cottjr/DMS-Laser-Cutter-Usage-Timer/Code and Verification/Verification/Yellow when need to pay.png

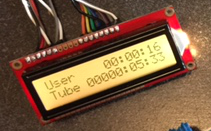
Code and Verification/Verification/Yellow when need to pay.png
