cottjr/DMS-Laser-Cutter-Usage-Timer/Code and Verification/Verification/IMG_8241.JPG

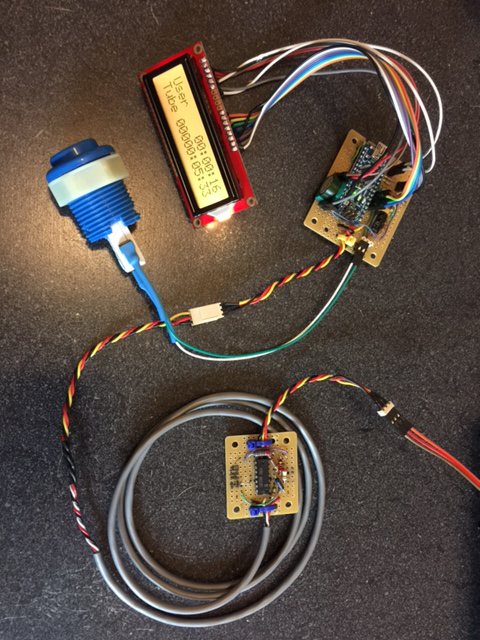
Code and Verification/Verification/IMG_8241.JPG
