cottjr/DMS-Laser-Cutter-Usage-Timer/Documentation/Schematic page 4 update - LCD contrast to fixed resistors.pdf

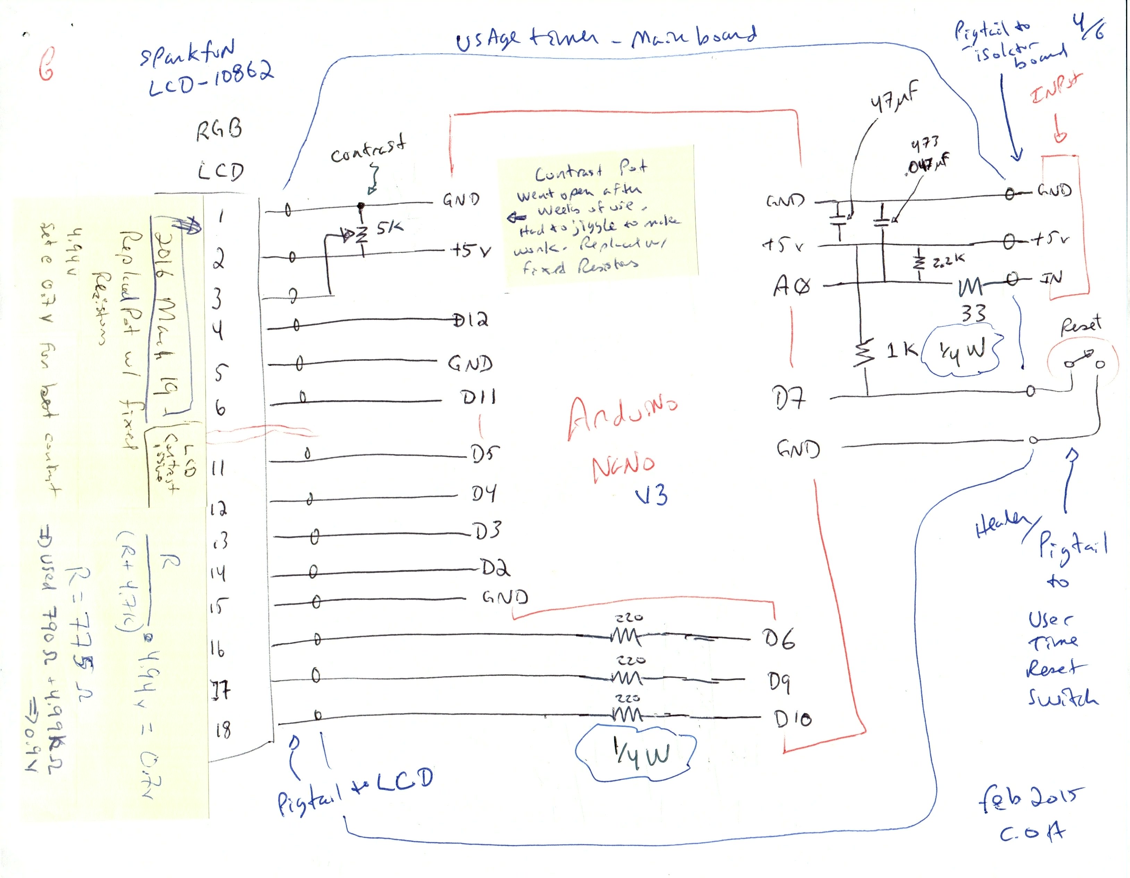
[picture p3: page 1]
