cottjr/DMS-Laser-Cutter-Usage-Timer/Documentation/Laser Cutter Usage Timer - As-Built v1.pdf

Laser Cutter Usage Timer - As-Built.docx

As-of May 2015

C.Ott

## Full Spectrum Cutter

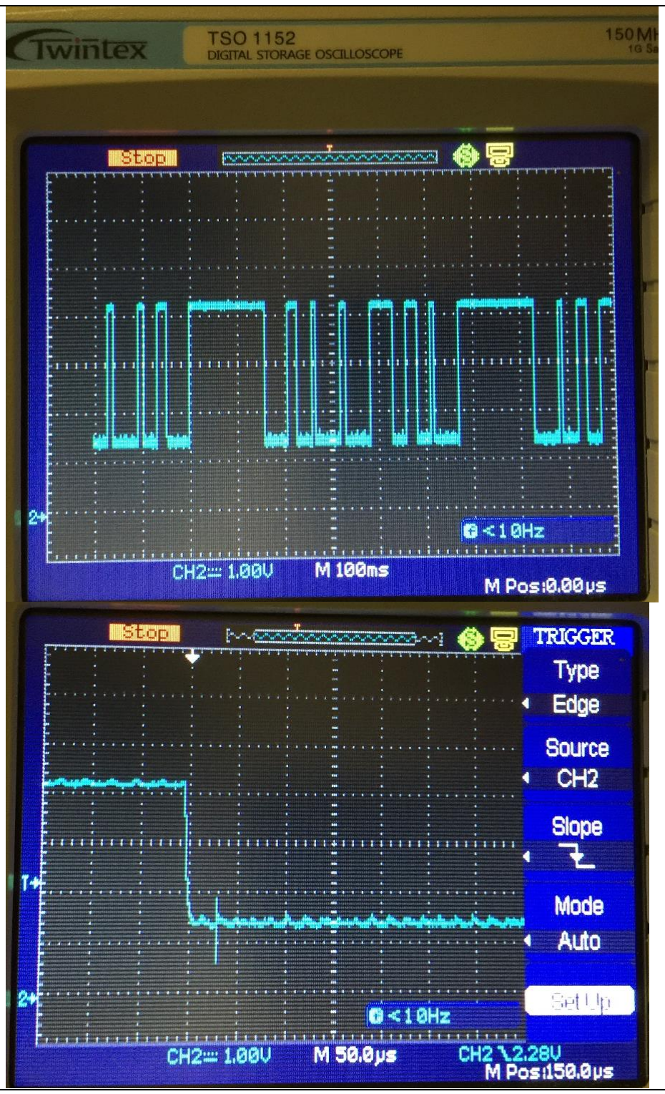
[picture p4: figure]

Logic Levels

(during a
raster cut)

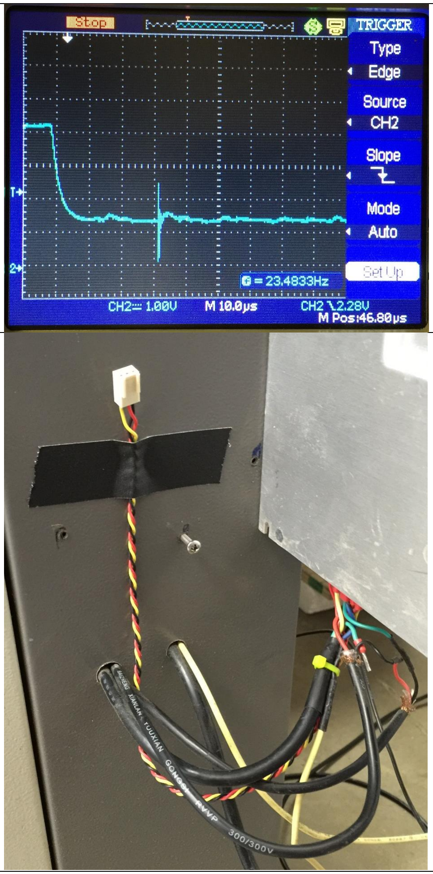
[picture p5: figure]

Twisted triple
pig-tail

With a keyed
connector

Note:
Interface card
located
physically
close to the
power supply

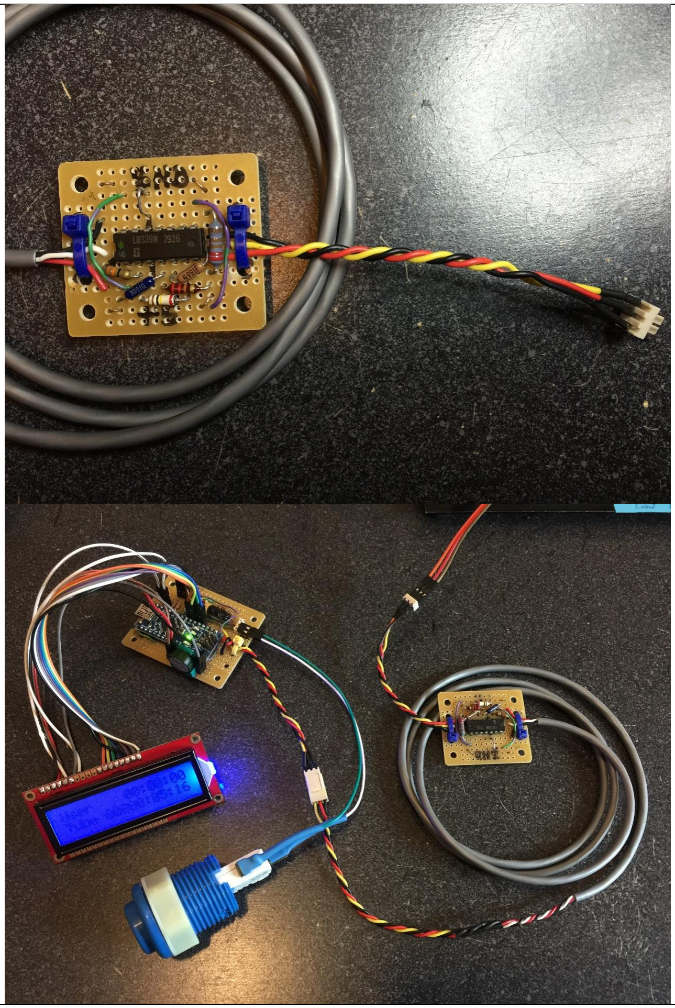
[picture p6: figure]

Kludgy
Construction

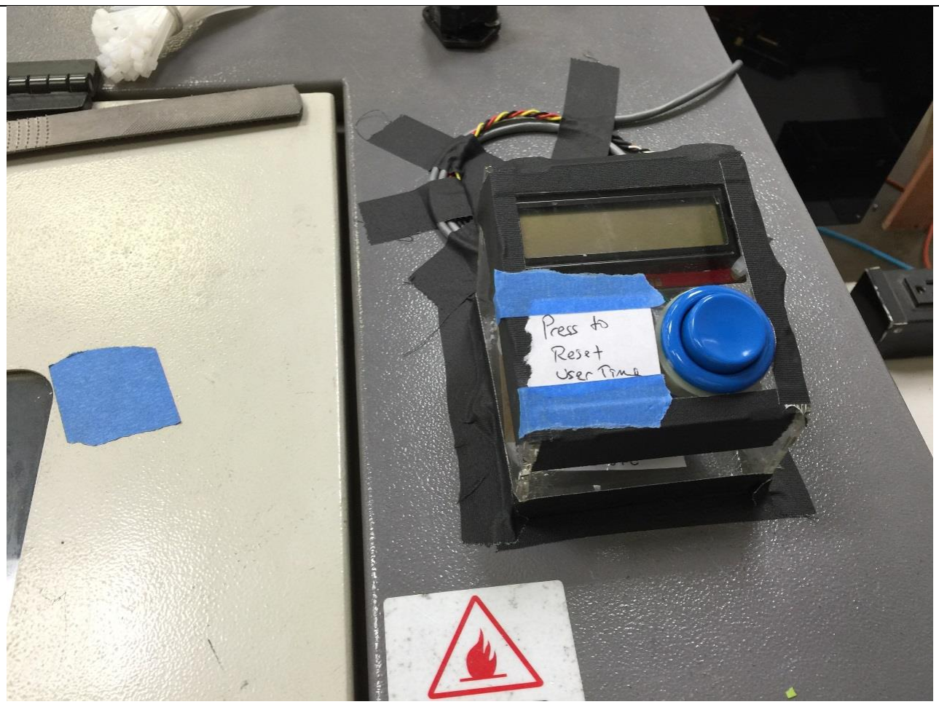
[picture p7: figure]

## LaserSaur

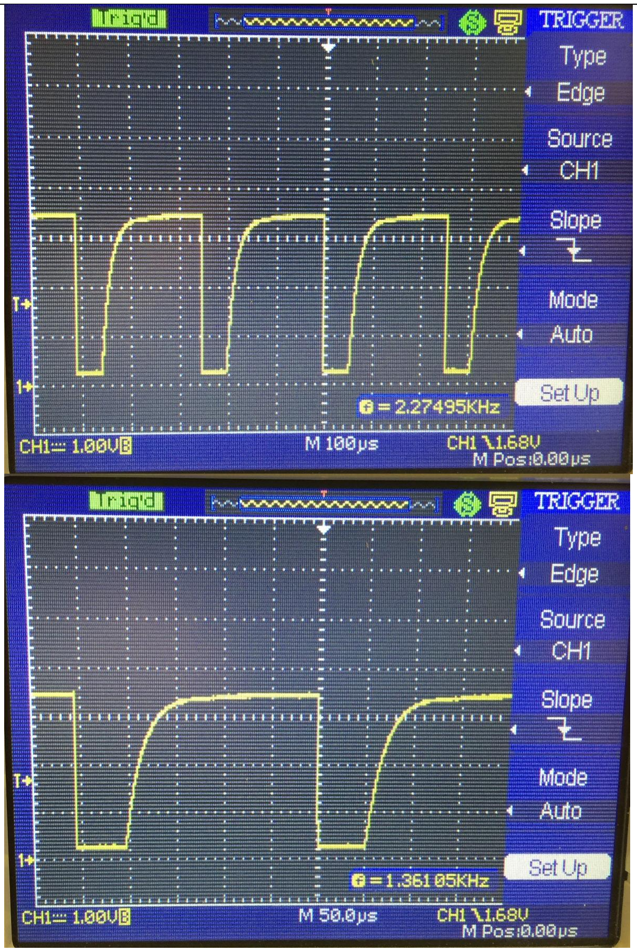
[picture p8: figure]

Logic Levels
