cottjr/DMS-Laser-Cutter-Usage-Timer/Code and Verification/Verification/IMG_8239.JPG

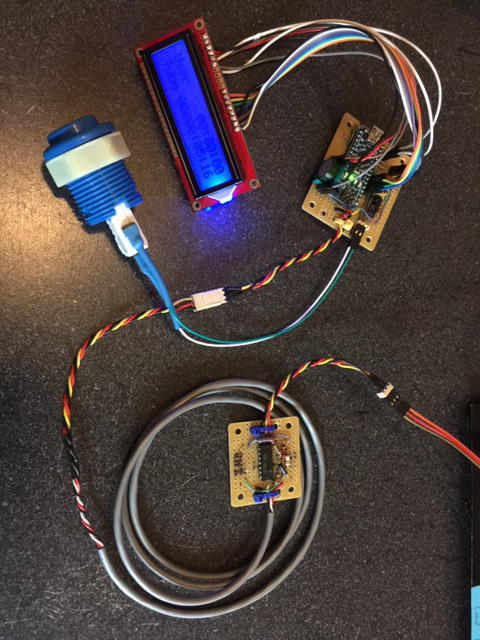
Code and Verification/Verification/IMG_8239.JPG
