cottjr/DMS-Laser-Cutter-Usage-Timer/Code and Verification/Verification/Red when firing.png

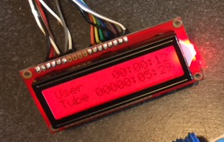
Code and Verification/Verification/Red when firing.png
