cottjr/DMS-Laser-Cutter-Usage-Timer/(commit log)

2015-11-13 I added round robin methods and configuration items to help minimize eeprom wear. Most changes are in EEPROMAnything.h. I adapted the code in the power monitor logic to call these new methods instead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
2016-03-20 V1.1 - Updated schematic page 4 to show replaced LCD contrast potentiometer with fixed resistors
2016-03-21 v2.0 - Ready to deploy to the DMS LaserSaur - added Round Robin EEPROM algorithm, - updated the LaserPowerMonitorZeroEEPROM code to improve maintenance instructions on the LCD display and on the seri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
    [LaserPowerMonitor.pde, LaserPowerMonitorZeroEEPROM.pde]
